xx0x/eh14/README.md

# Časotron EH14

Časotron EH14 is a digital clock, featuring mechanical displays and voice.

There aren't all the assets listed here, the repository is meant as an inspiration for others – and for backup :-)

## Introduction video (in Czech)

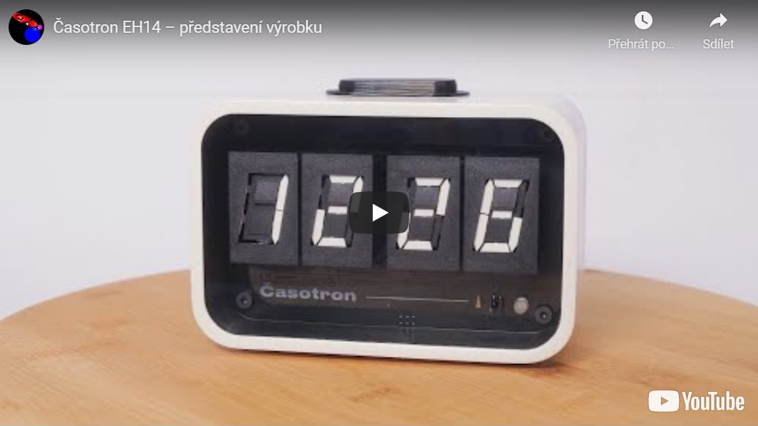
[picture p1: docs/eh14-video.jpg]
Video introduction (http://www.youtube.com/watch?v=cbuomJwm30c "Video introduction")


## Product website

https://www.xx0x.cz/
