xx0x/eh14/schematics/eh14-main-board-schematics.pdf

# XTAL1 XTAL¹

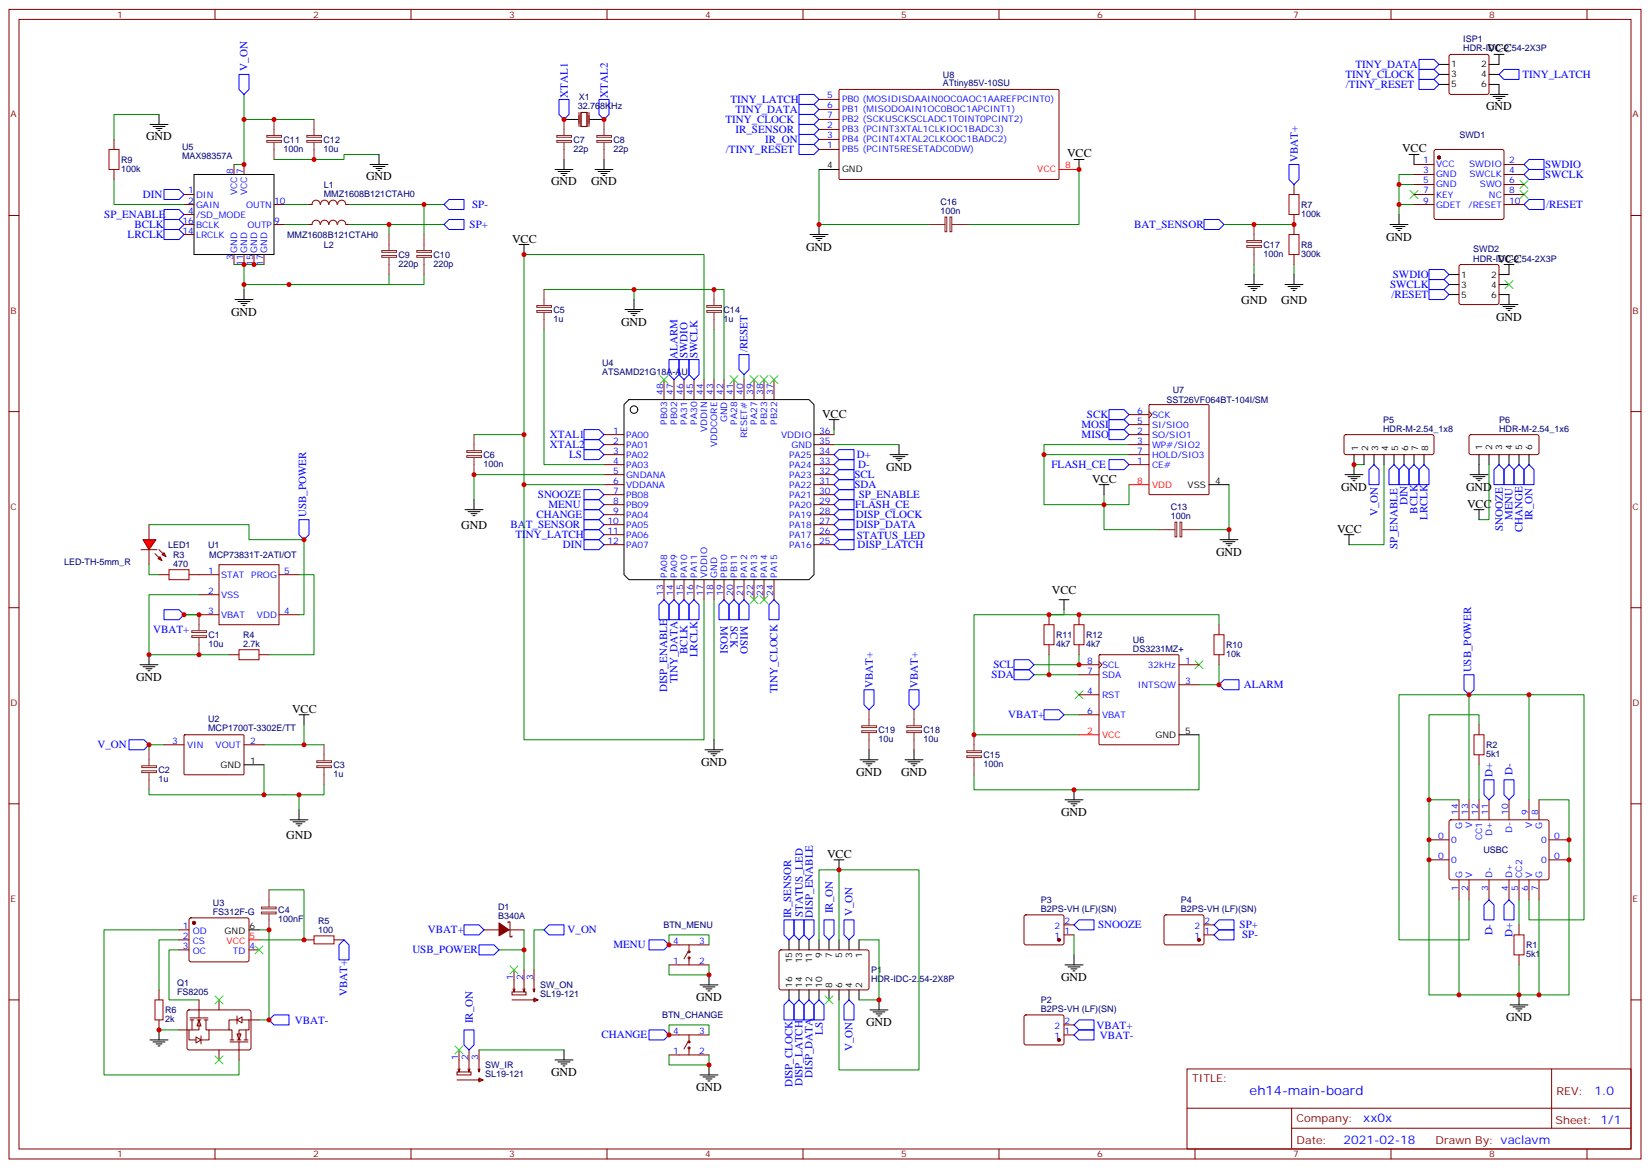
[picture p4: page 1]

GND 17 GND 15 GND 11 VCC

PB22 37 PB23 38 PA27 39 RESET# 40 PA28 41 GND 42 VDDCORE 43 VDDIN 44 PA30 45 PA31 46 PB02 47 PB03 48
PA16 25 PA17 26 PA18 27 PA19 28 PA20 29 PA21 30 PA22 31 PA23 32 PA24 33 PA25 34 GND 35 VDDIO 36
