xx0x/eh14/schematics/eh14-rc-schematics.pdf

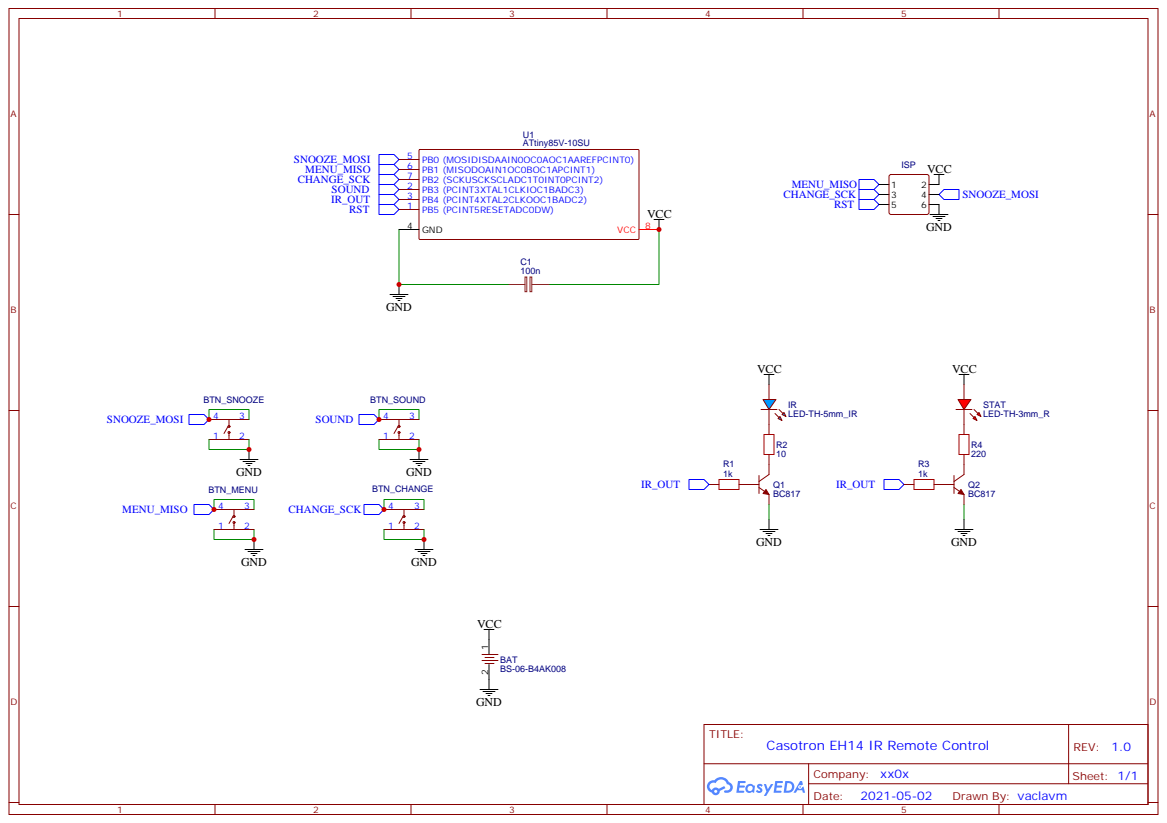
[picture p5: page 1]
