xx0x/eh14/schematics/eh14-display-board-schematics.pdf

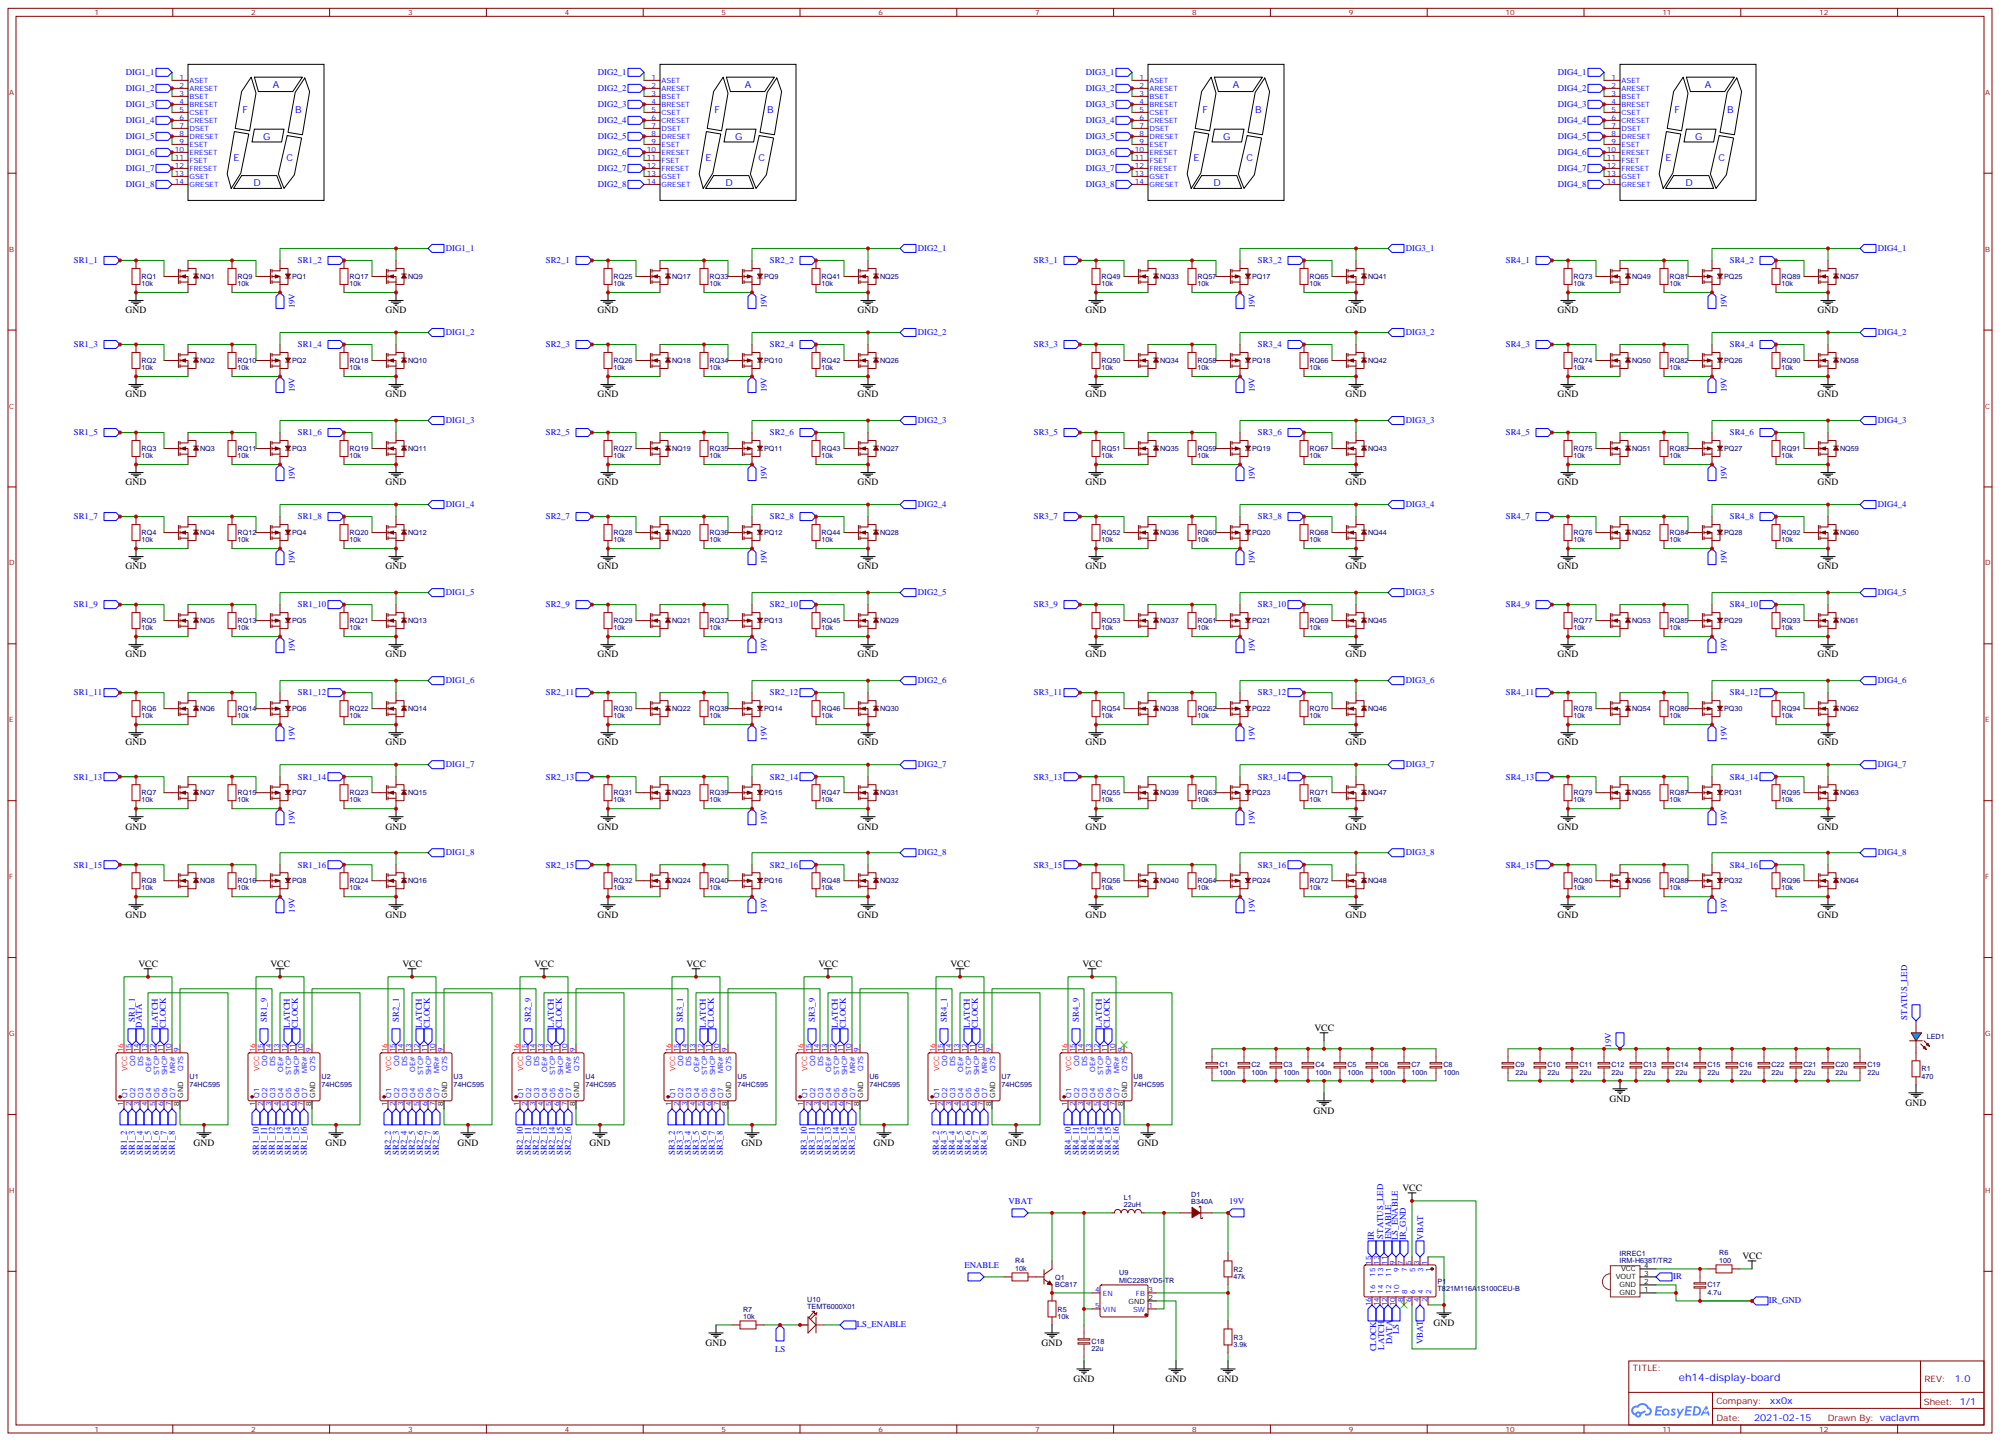
[picture p6: page 1]

9 MR# 10 SHCP 11 STCP 12 OE# 13 DS 14 Q0 15 VCC 16
