xx0x/eh14/firmware/eh14/pins.h

// Buttons
#define PIN_SNOOZE_BUTTON       15
#define PIN_MENU_BUTTON         16
#define PIN_CHANGE_BUTTON       17

// Display
#define PIN_DISPLAY_ENABLE      4
#define PIN_DISPLAY_DATA        10
#define PIN_DISPLAY_LATCH       11
#define PIN_DISPLAY_CLOCK       12
#define PIN_DISPLAY_LED         13

// Audio
#define PIN_I2S_FS              0   // LRC
#define PIN_I2S_SCK             1   // BCLK
#define PIN_I2S_TX              9   // DIN
#define PIN_I2S_RX              2   // not used

// Other
#define PIN_FLASH_CS            6
#define PIN_SPEAKER_ENABLE      7
#define PIN_LIGHT_SENSOR        14
#define PIN_BATSENSOR           18
#define PIN_ALARM               19

// TEMP PINS FOR TESTING
// #define PIN_IR_LATCH    18
// #define PIN_IR_DATA    14
// #define PIN_IR_CLOCK    17 

#define PIN_IR_LATCH    8
#define PIN_IR_DATA    3
#define PIN_IR_CLOCK    5
