xx0x/eh14/(commit log)

2021-03-12 add button mappings
2021-03-14 add smartDelay (stops when a button pressed)
2021-03-17 IR rework to use a separate attiny85
    [eh14.ino, eh14_ir_reciever.ino, globals.h, pins.h]
2021-03-17 flash led when IR recieved, menu timeout 60s
2021-04-03 reset change button when menu enter/next item
    [eh14.ino]
2021-04-25 fix pins, IR working
    [pins.h]
2021-04-25 button interrupts code cleanup
2021-04-25 don't sleep if button pressed
2021-05-02 revert back to linear segmentOrder
    [display.h, globals.h]
2021-05-03 fix goto sleep in silent mode
    [eh14.ino]
2021-05-03 add high power (=no sleep) silent mode
2021-05-03 reciever sleep on startup to save power
2021-05-04 flash in samples offset to 4k, using first bytes for settings
2021-05-04 time in settings display fix
    [eh14.ino]
2021-05-04 button delay when volume change
2021-05-05 add battery charge measure
2021-05-06 fix infinite alarm loops
    [eh14.ino]
2021-05-09 fix sleep when IR recieving
    [eh14.ino, globals.h]
2021-05-30 fix turn off status led after flashing complete
    [flash.h]
2021-05-30 add threshold for waking up to prevent loops
    [eh14.ino]
2021-06-01 flash low battery if less than 20 perc
2021-06-11 add schematics, update readme
2021-06-18 add rc schematics
2021-08-09 fix millis overflow issue which prevented buttons to work
    [eh14.ino]
2021-08-09 update battery min value
2021-10-18 re-display time after saying (in case time changed)
